Vitech-UA/Freq-invertor-v-1.0/Мої доробки/cxem.jpg

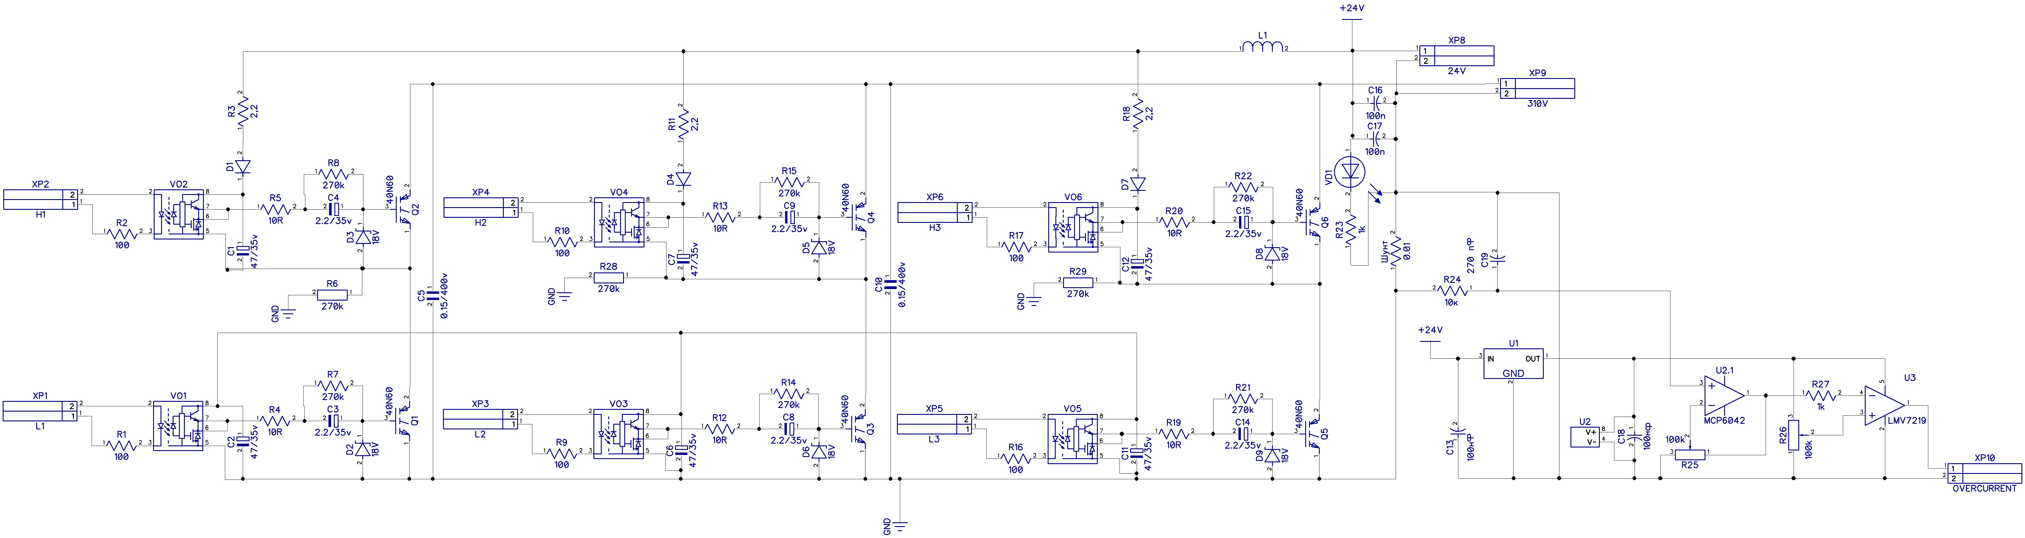
Мої доробки/cxem.jpg
