Vitech-UA/Freq-invertor-v-1.0/ControlBoard.pdf

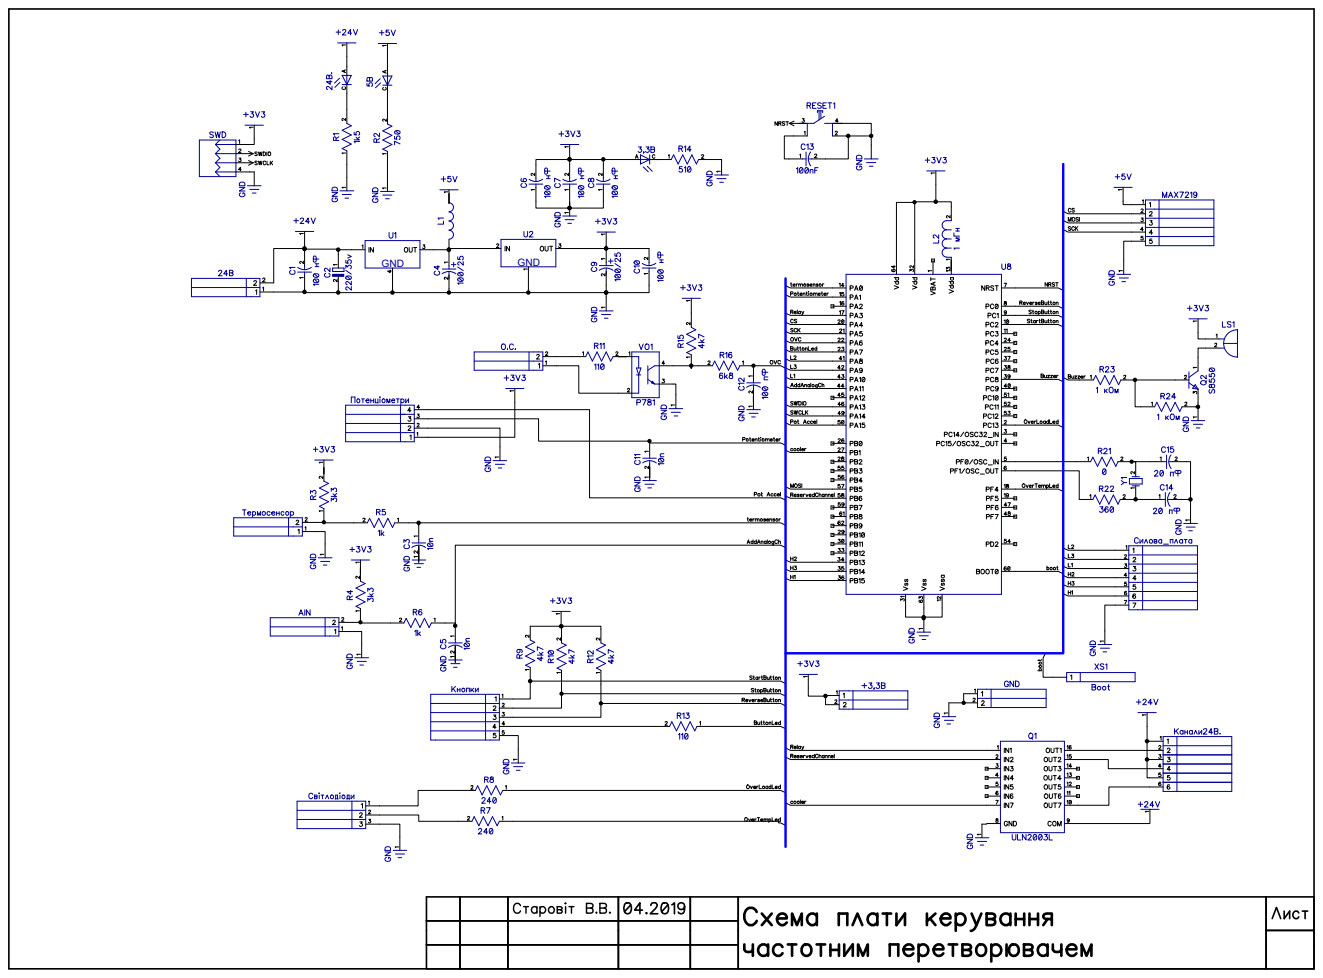
[picture p20: page 1]
GND
