Vitech-UA/Freq-invertor-v-1.0/(list of files, drawings)

Other design files:
Мої доробки/1_V_Частотник.dip
Мої доробки/Варіант силової плати.dip
Мої доробки/Відладочна для частотника IR2130+HCPL2531.dip
Мої доробки/Плата, що замовлена на JLCPCB/pcb_v 3.0(DIP TRACE 22.01.2019).dip
Мої доробки/Плата, що замовлена на JLCPCB/Схема силової частини з Оптодрайверами HCPL-3120 і схемою контролю від над струму.dch
Мої доробки/Силова частина мого інвертора.dch
Мої доробки/Симуляція схеми захисту від КЗ.DSN
Мої доробки/Симуляція схеми захисту від перенапруги у ланці DC.ms14
Мої доробки/Симуляція схеми захисту по струму.ms14
Мої доробки/Схема плати керування мого частотника_Остання Версія(Для розводки).dch
Мої доробки/Схема плати керування мого частотника_Остання Версія.dch
Плати/Відладочна для частотника IR2130+HCPL2531 — копия.dip
Плати/Плата, що замовлена на JLCPCB/pcb_v 3.0(Відправлена на виробнитство 07.01.2018).dip
Плати/Плата, що замовлена на JLCPCB/Схема силової частини з Оптодрайверами HCPL-3120 і схемою контролю від над струму.dch
Плати/Плата, яка буде взята за основу і на продакшн.dip
